plocher/IO4-QuadOD/QuadOD-Graphic.png

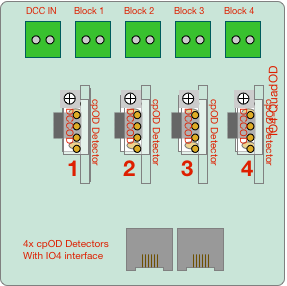
QuadOD-Graphic.png
