plocher/IO4-QuadOD/IO4-QuadOD.brd

## EAGLE design IO4-QuadOD.brd (2020-10-06)

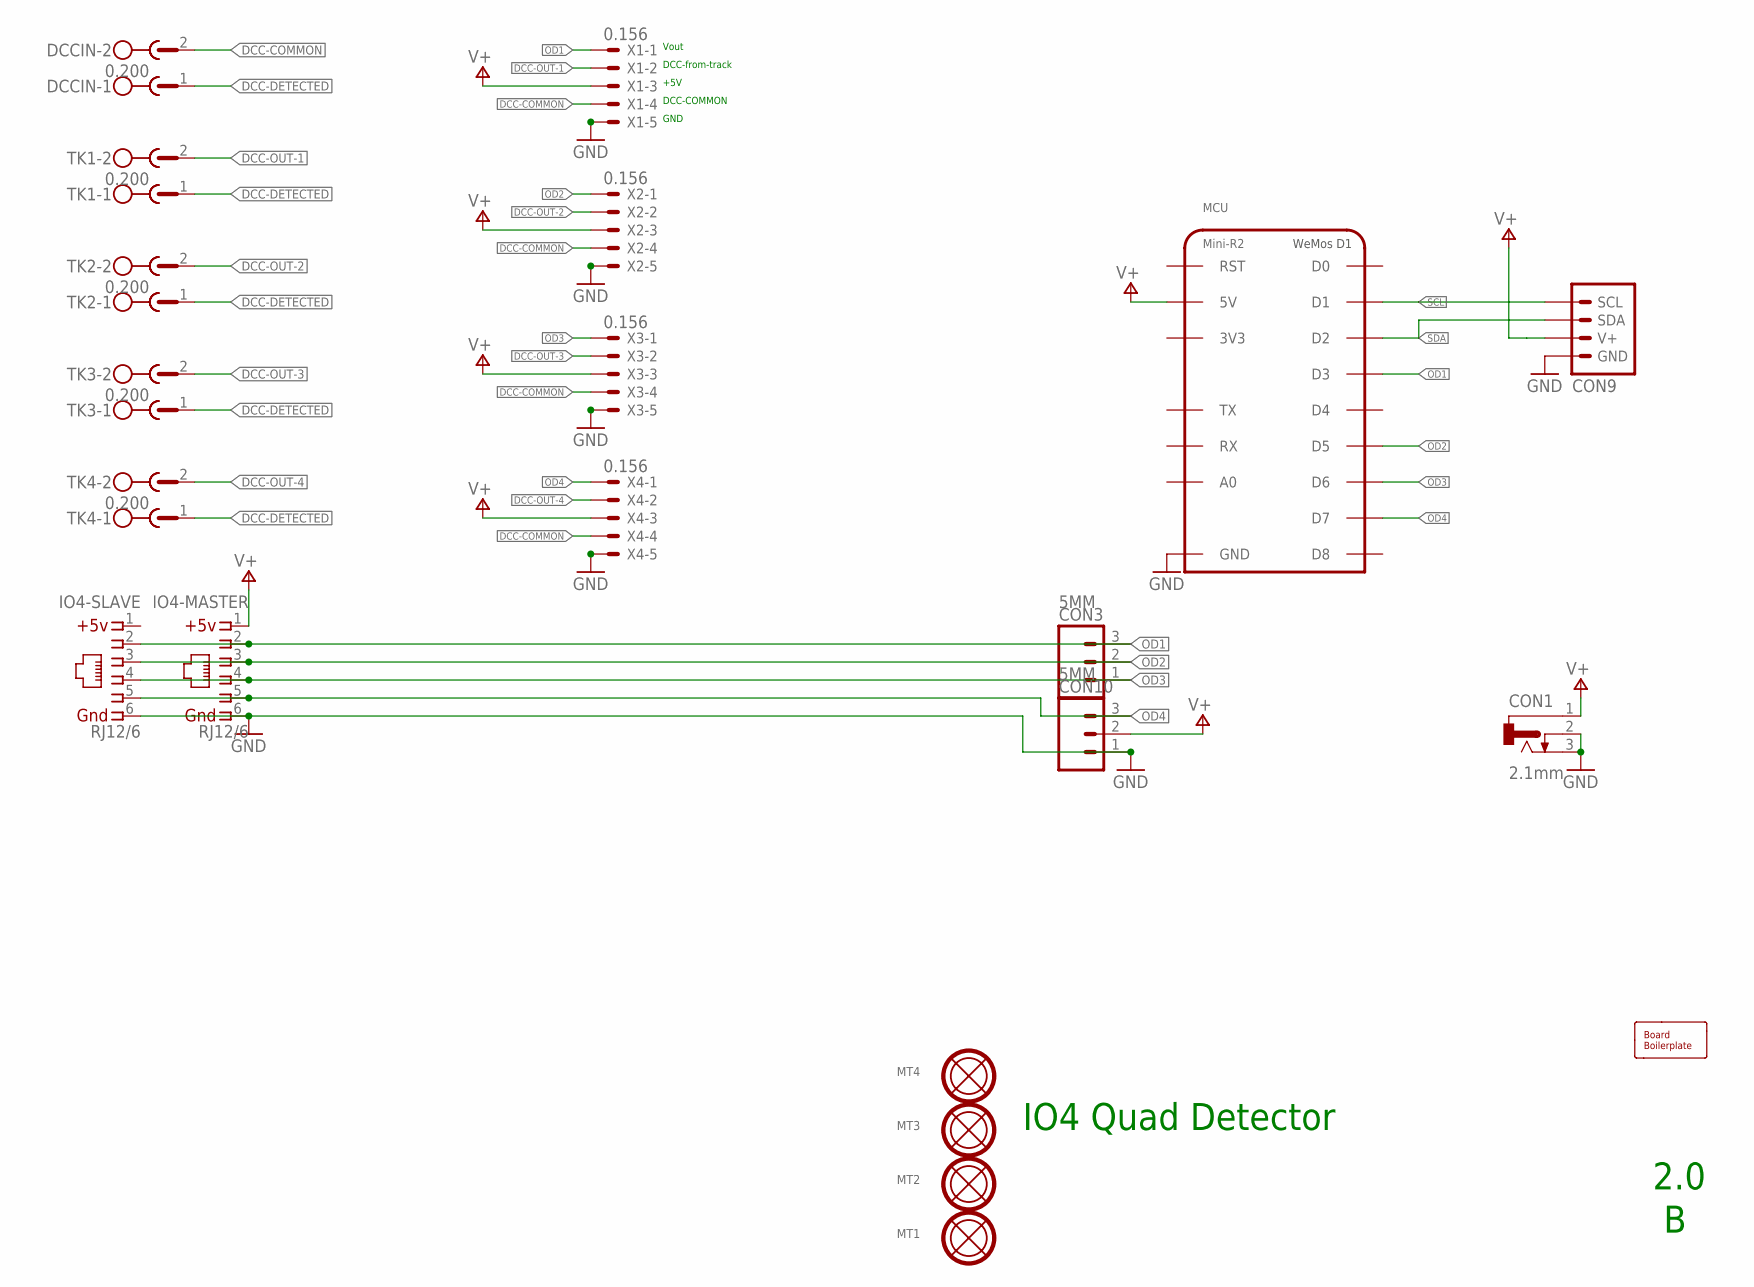
[picture p2: schematic IO4-QuadOD.sch]

Parts:
BOARD1: BOARD; BOARD-SEEED10X10-NOHOLES
CON1: 2.1mm; DCJ0202
CON3, CON10: 5MM; SCREWTERMINAL-5MM-3
CON9: CONNECTOR-I2CLEFT; I2C-L
DCCIN: 0.200; MSTBA2
IO4-MASTER, IO4-SLAVE: RJ12/6; RJ25-INVERTED
MCU: Mini-R2; WEMOS-D1
MT1, MT2, MT3, MT4: MOUNTINGHOLE
TK1, TK2, TK3, TK4: 0.200; MSTBA2
X1, X2, X3, X4: 0.156; KK-156-5

Connections:
1: IO4-SLAVE.1
DCC-COMMON: DCCIN.2, X1.4, X2.4, X3.4, X4.4
DCC-DETECTED: DCCIN.1, TK1.1, TK2.1, TK3.1, TK4.1
DCC-OUT-1: TK1.2, X1.2
DCC-OUT-2: TK2.2, X2.2
DCC-OUT-3: TK3.2, X3.2
DCC-OUT-4: TK4.2, X4.2
GND: CON1.2, CON1.3, CON9.GND, CON9.GND@1 (GND), CON10.1, IO4-MASTER.6, IO4-SLAVE.6, MCU.GND, X1.5, X2.5, X3.5, X4.5
OD1: CON3.3, IO4-MASTER.2, IO4-SLAVE.2, MCU.D3, X1.1
OD2: CON3.2, IO4-MASTER.3, IO4-SLAVE.3, MCU.D5, X2.1
OD3: CON3.1, IO4-MASTER.4, IO4-SLAVE.4, MCU.D6, X3.1
OD4: CON10.3, IO4-MASTER.5, IO4-SLAVE.5, MCU.D7, X4.1
SCL: CON9.SCL, CON9.SCL@1 (SCL), MCU.D1
SDA: CON9.SDA, CON9.SDA@1 (SDA), MCU.D2
V+: CON1.1, CON9.V+, CON9.V+@1 (V+), CON10.2, IO4-MASTER.1, MCU.5V, X1.3, X2.3, X3.3, X4.3

Notes on the sheet:
IO4 Quad Detector
2.0
Vout
DCC-from-track
+5V
DCC-COMMON
GND

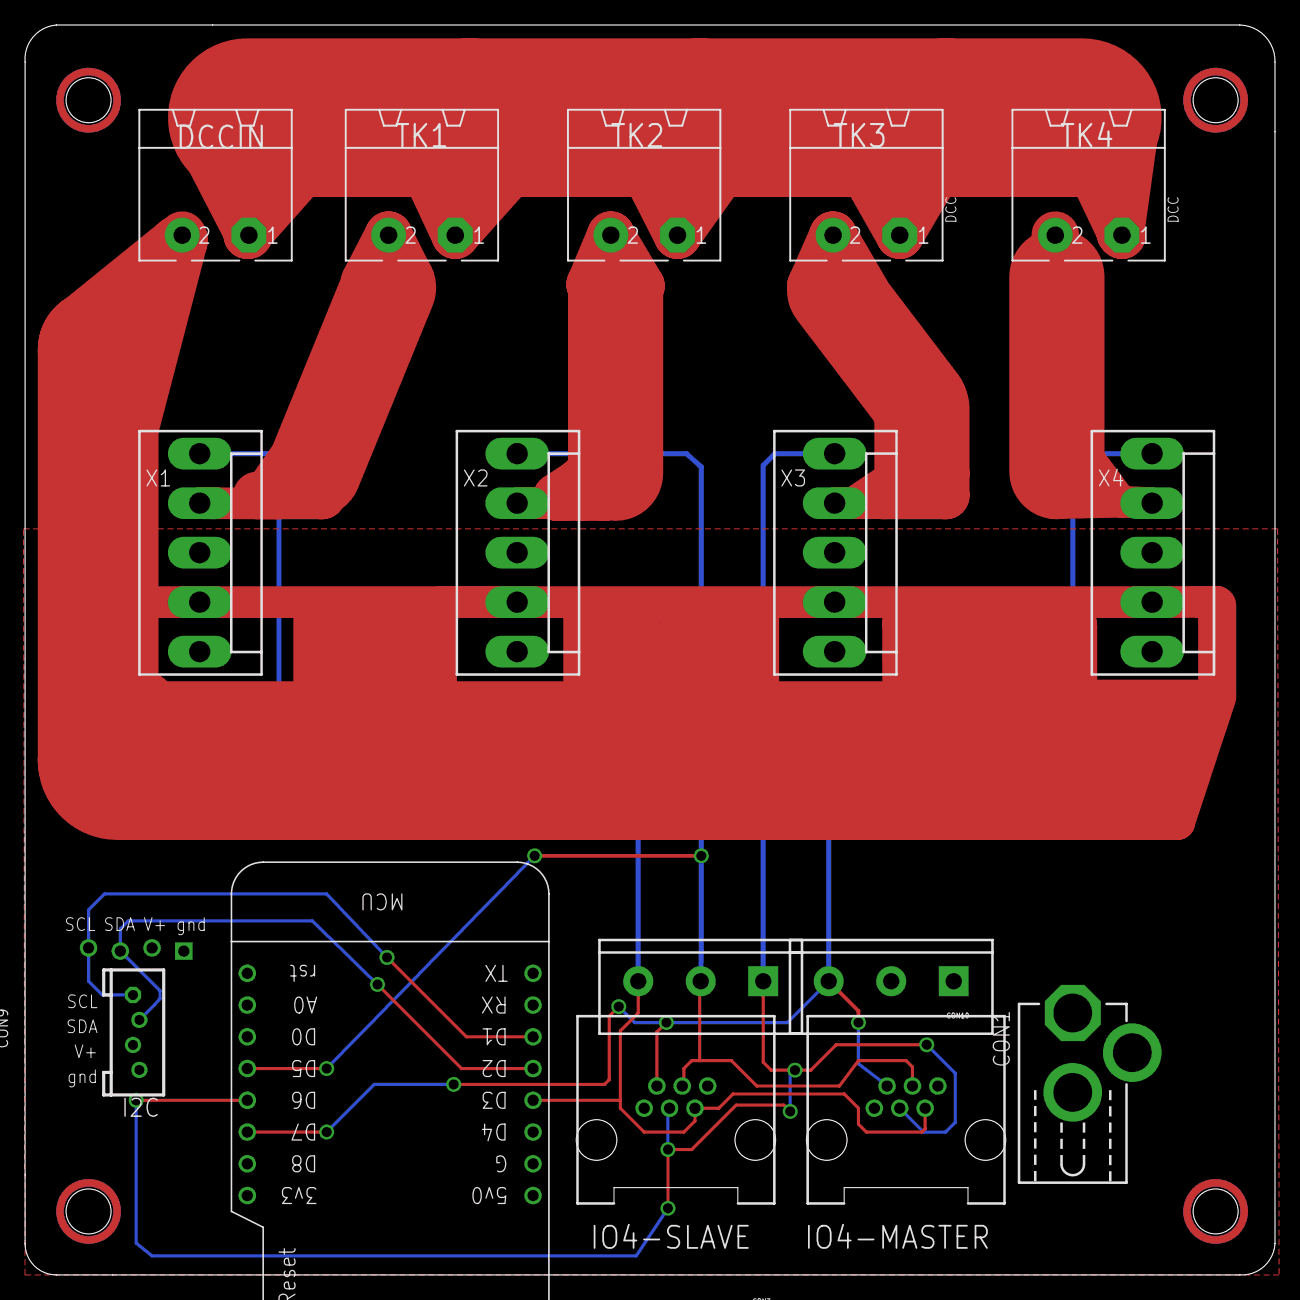
[picture p3: board IO4-QuadOD.brd from above]

Board: 2 copper layers, 100.0 x 100.0 mm, 21 parts (0 on the bottom side), 14 nets.
