plocher/IO4-QuadOD/(commit log)

2020-10-05 added values for connectors
    [IO4-QuadOD.brd, IO4-QuadOD.sch]
2020-10-06 normalized values
    [IO4-QuadOD.brd, IO4-QuadOD.sch]
